ahmetkusay-rgb/Taskin_2204-D/(commit log)

2026-03-21 feat: initial commit — TASKIN ESP32 flood monitoring system
    - node_21.02: sensor node firmware (HC-SR04 + ESP-NOW broadcast)
    - merkez_10.03: hub firmware (ESP-NOW rx, SD card CSV logging)
    - server.py: Python serial-to-WebSocket bridge
    - index.html: real-time dashboard (Leaflet map + sparklines)
    - data/samples: field test CSV data (Adana, Feb 2026)
    - docs: system diagram and screenshots
    - README: full academic report summary, TRI risk index, hardware BOM
2026-03-21 docs: separate BOM to Excel and extract schematics and raw data notes
    [Malzeme_Listesi.xlsx]
2026-03-21 docs: add raw field test csv data
    [saha_node1_09subat_s1_11-14.csv, saha_node1_09subat_s2_16-19.csv, saha_node2_10800.csv, saha_node3_11subat_08-11.csv]
2026-03-21 refactor: jury-ready restructure — new README, docs, analysis, LICENSE, firmware/
2026-03-21 docs: bilingual README (EN+TR), battery data, node naming fixes, simplified MISSING.md
2026-03-21 Update cost of sensor system in conclusion section
2026-03-21 Revise current draw and components in README
    Updated current draw values and components in the table.
2026-03-21 Add saha_node2_10subat.csv file
    [saha_node2_10subat.csv]
2026-03-21 Translate Circuit Diagram documentation to English
2026-06-20 Update node firmware with JSN-SR04T improvements
    - Median filtering over multiple readings to reject noise
    - ECHO_TIMEOUT increased to 150 ms for JSN-SR04T echo delay
    - Minimum reliable distance (SENSOR_MIN_CM) and physical range guards
    - Preserve last valid fill level on failed measurement instead of garbage
    - Replace map() with float arithmetic for fill percentage
    - Serial debug output of distance and fill level
    [node_21.02.ino]
2026-06-20 Reorganize repo to target layout and fix TRİ score calculation
    Repository structure (per target tree):
    - firmware/node/node.ino, firmware/merkez/merkez.ino
    - software/{server.py,index.html}
    - analysis/tri_score.py
    - docs/hardware/{baglanti_semasi.md,malzeme_listesi.md}, docs/images/
    - Component_List.xlsx -> docs/hardware/malzeme_listesi.md (markdown)
    Hub firmware (merkez.ino):
    - Add SD recovery: re-init + retry on write failure or card drop
    (cooldown-limited), SD_FAIL/SD_RECOVERED status lines, background
    reconnect in loop()
    TRİ calculator (tri_score.py) bug fixes:
    - Fix rise metric direction: was rewarding the SLOWER riser. Replaced the
    fragile 20->80 transition time (NaN when a c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
    [merkez.ino, node.ino, server.py]
2026-06-21 Align TRİ calculator and sample data with final presentation results
    - Rewrite tri_score.py to the documented MCDM method (Malczewski weighted
    combination): mean & max used directly (already 0-100%), duration/
    frequency/rise-rate min-max normalized, equal weights. Hybrid is the
    default; --method minmax reproduces the initial variant for the
    sensitivity check. Output now matches the talk: Barajyolu 91 (Critical),
    Turgut Ozal 49 (Medium), Sinanpasa 9 (Low).
    - Regenerate data/samples so the open data reproduces the reported field
    parameters (max 94/82/29, 168/54/0 s above 80%, 7/3/0 crossings, rise
    rate 1.85x) and the highest-variance-at-Barajyolu finding; previously the
    synthe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
    [saha_node1_09subat_s1_11-14.csv, saha_node1_09subat_s2_16-19.csv, saha_node2_10subat_12-15.csv, saha_node3_11subat_08-11.csv]
2026-06-21 Add report figures to docs/images and embed them in the READMEs
    Extracted from the project report and appendices (ekler_v2 / RAPOR_v10):
    - architecture diagram, hub hardware, node enclosure, 3 field-station photos
    - hub & node wiring diagrams, lab setup, dashboard, time-series chart
    Embedded at the matching README/README_TR sections (architecture, hardware,
    physical design, wiring, lab, field test). Noted that the report's EK-5.1
    hub diagram shows default VSPI pins while the firmware remaps SPI to
    12/13/11/10 (baglanti_semasi.md and wiring captions clarify this).
2026-06-21 Align hub SPI pins with the report wiring diagram (EK-5.1)
    Set the merkez SD-card SPI pins to match the report's EK-5.1 diagram/table
    (SCK 18, MISO 19, MOSI 23, CS 5) instead of 12/13/11/10:
    - firmware/merkez/merkez.ino: SPI.begin(18, 19, 23, 5)
    - baglanti_semasi.md, README.md, README_TR.md: pin tables, SPI.begin text,
    and wiring captions updated; removed the firmware/diagram discrepancy note
2026-11-06 Fix setup, sensor handling and analysis; simplify project documentation
    [merkez.ino, node.ino, server.py]
